Yourm5m5/InkDeck/CAD/images/inkdeck-drawing.png

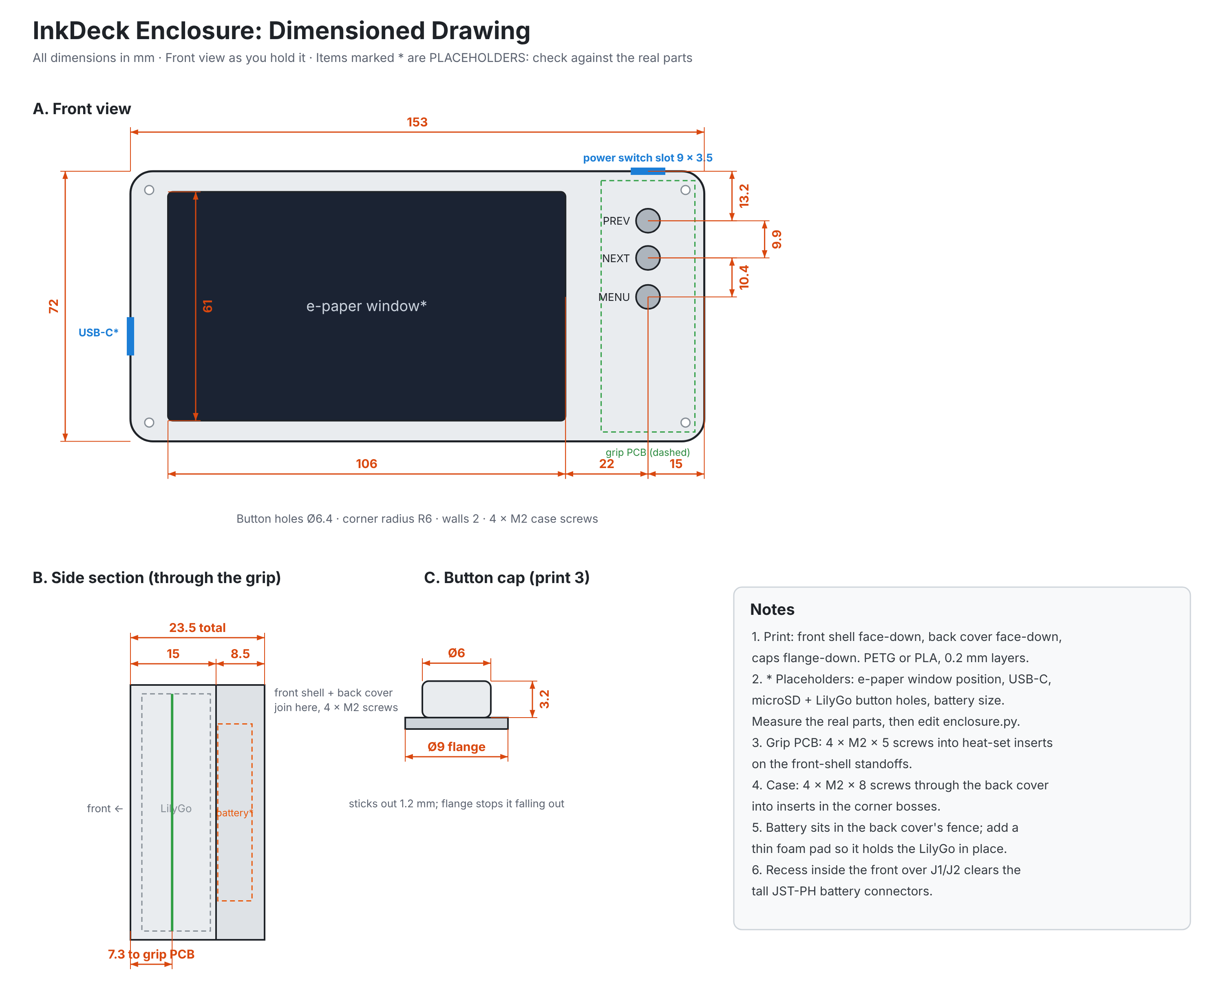
CAD/images/inkdeck-drawing.png
