Yourm5m5/InkDeck/CAD/images/inkdeck-exploded-rear.png

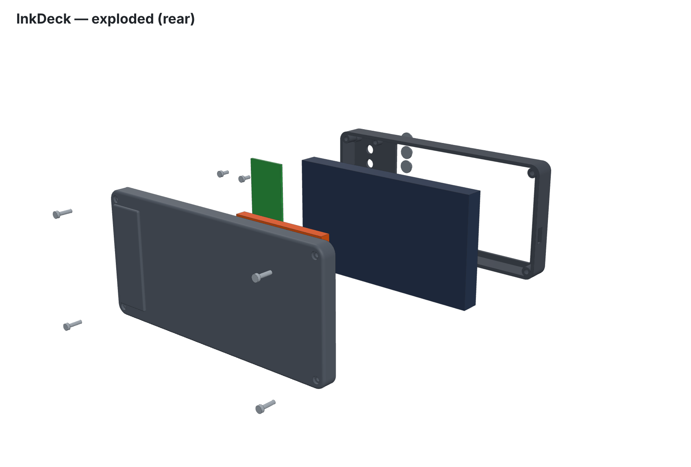
CAD/images/inkdeck-exploded-rear.png
