Yourm5m5/InkDeck/CAD/step/inkdeck_assembled_assembly.step

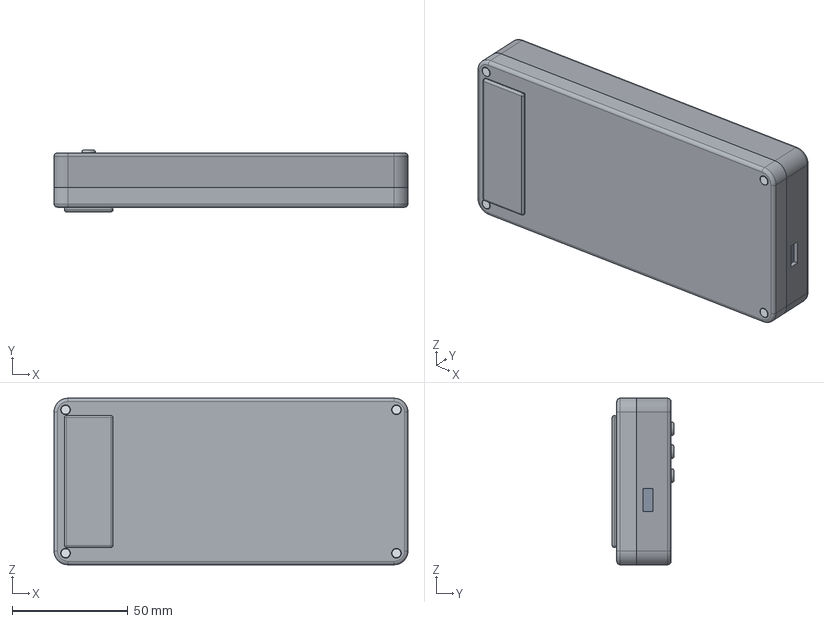
[picture p3: CAD file, 2026-10-25]
CAD/step/inkdeck_assembled_assembly.step
153.0 x 26.7 x 72.0 mm
caps
front
screen
lilygo
buttons
conns
grip
pscrew
battery
motor
back
cscrew
