Yourm5m5/InkDeck/CAD/step/inkdeck_exploded_assembly.step

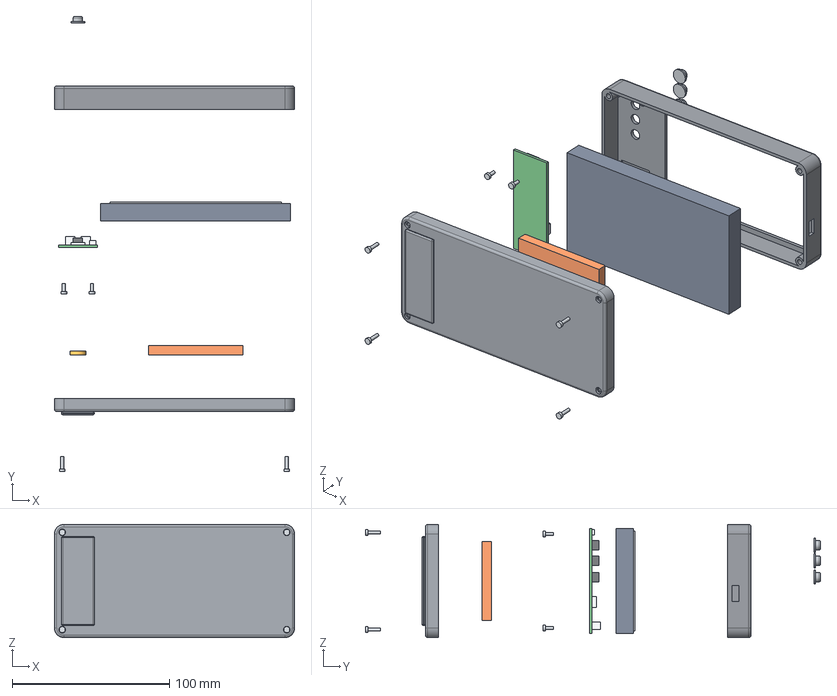
[picture p4: CAD file, 2026-10-25]
CAD/step/inkdeck_exploded_assembly.step
153.0 x 289.8 x 72.0 mm
caps
front
screen
lilygo
buttons
conns
grip
pscrew
battery
motor
back
cscrew
