Yourm5m5/InkDeck/CAD/step/inkdeck_assembly.step

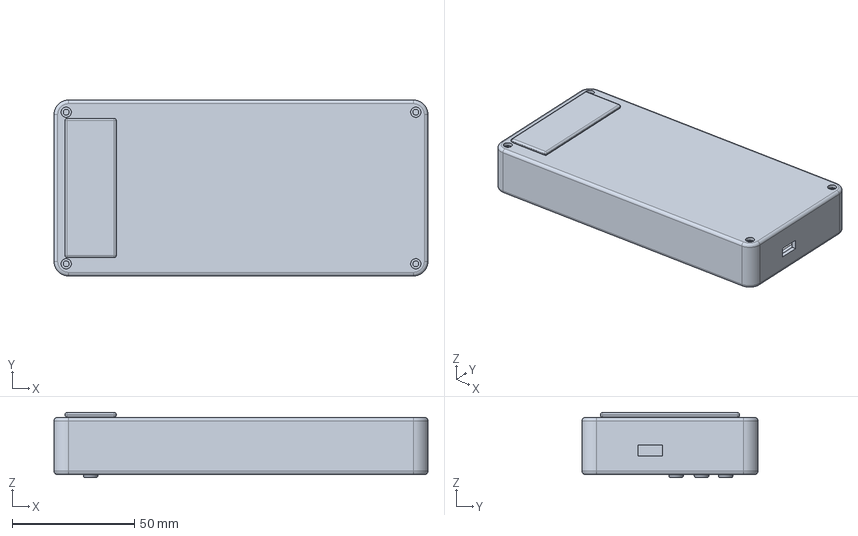
[picture p5: CAD file, 2026-10-17]
CAD/step/inkdeck_assembly.step
153.0 x 72.0 x 26.7 mm
