Yourm5m5/InkDeck/PCB/pcb.step

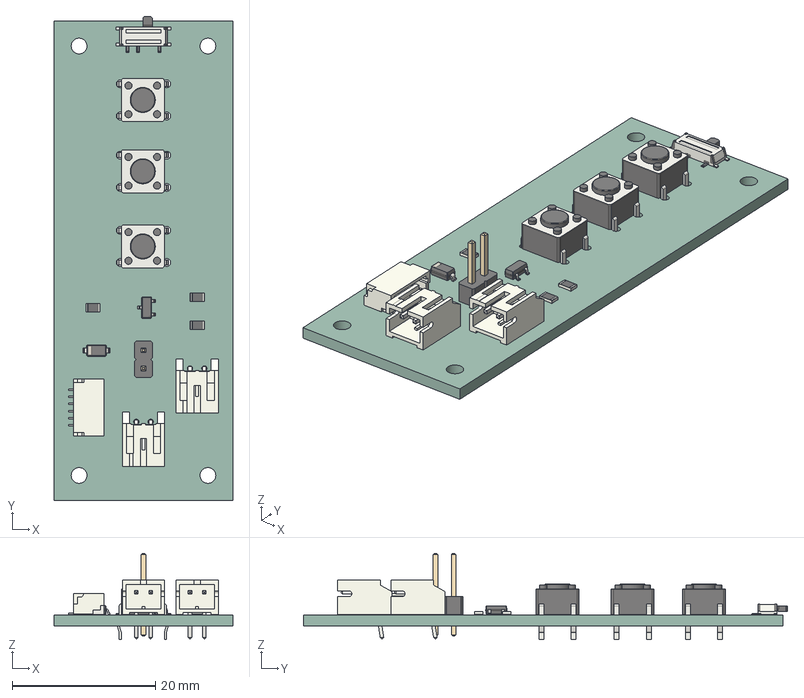
[picture p6: CAD file, 2026-10-25]
PCB/pcb.step
25.0 x 67.6 x 12.0 mm
JST_S2B_PH_K x 2
D_SOD-123
R_0805_2012Metric x 3
SW_PUSH_6mm x 3
Fusion_sp
PinHeader_1x02_P254mm_Vertical
SOT-23
JST_SH_SM06B-SRSS-TB_1x06-1MP_P1.00mm_Horizontal
Inkdeck_PCB
