Yourm5m5/InkDeck/CAD/step/inkdeck_back_cover.step

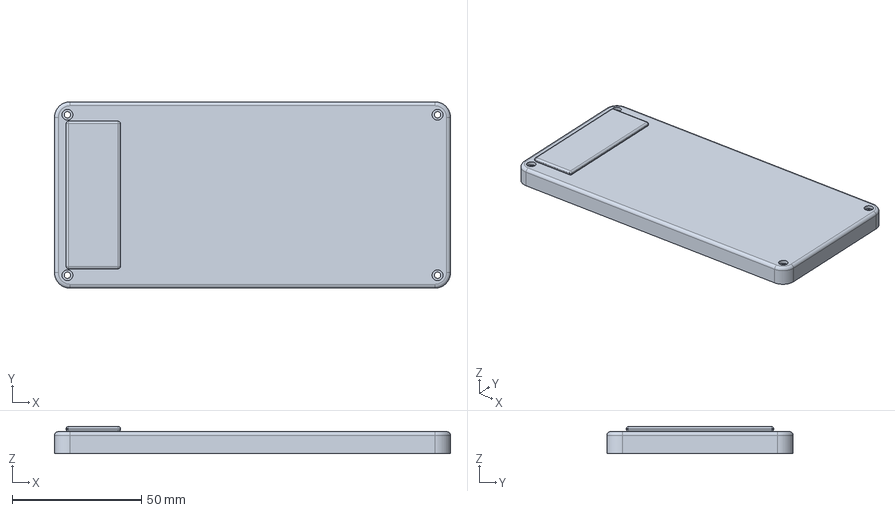
[picture p7: CAD file, 2026-10-17]
CAD/step/inkdeck_back_cover.step
153.0 x 72.0 x 10.5 mm
