Yourm5m5/InkDeck/CAD/step/inkdeck_button_cap.step

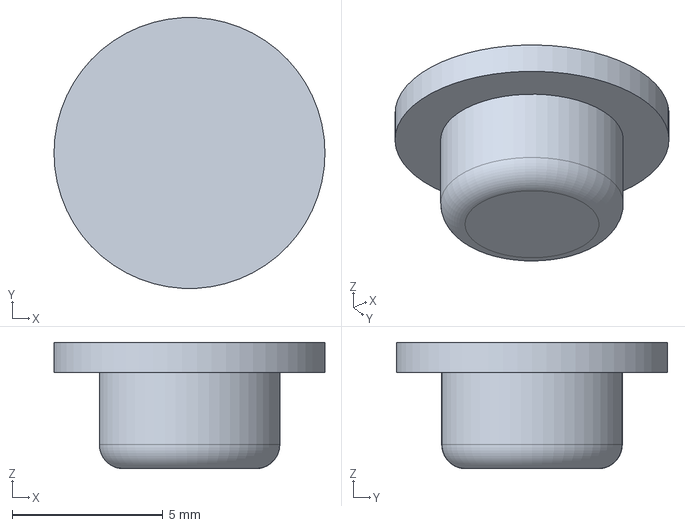
[picture p8: CAD file, 2026-10-17]
CAD/step/inkdeck_button_cap.step
9.00 x 8.99 x 4.20 mm
