Yourm5m5/InkDeck/CAD/step/inkdeck_front_shell.step

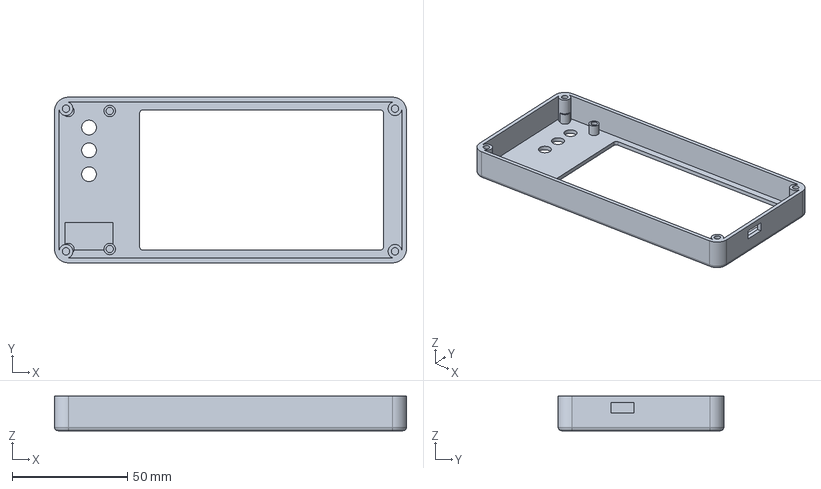
[picture p9: CAD file, 2026-10-17]
CAD/step/inkdeck_front_shell.step
153.0 x 72.0 x 15.0 mm
