Yourm5m5/InkDeck/(list of files, cad)

Other CAD files:
CAD/f3zfd3/inkdeck_assembled_assembly.f3z
CAD/f3zfd3/inkdeck_assembly.f3d
CAD/f3zfd3/inkdeck_back_cover.f3d
CAD/f3zfd3/inkdeck_button_cap.f3d
CAD/f3zfd3/inkdeck_front_shell.f3d
CAD/stl/inkdeck_assembly.stl
CAD/stl/inkdeck_back_cover.stl
CAD/stl/inkdeck_button_cap.stl
CAD/stl/inkdeck_front_shell.stl
