Yourm5m5/InkDeck/CAD/images/inkdeck-assembled.png

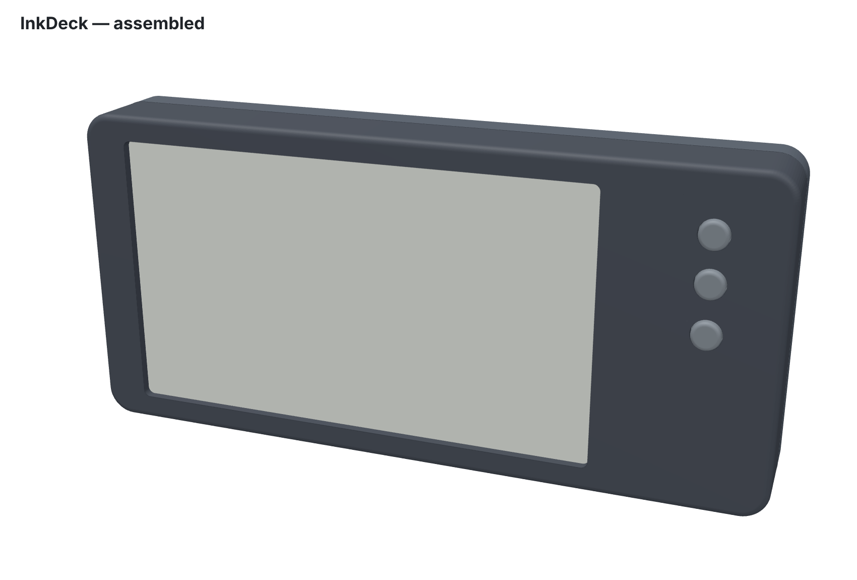
CAD/images/inkdeck-assembled.png
