Yourm5m5/InkDeck/PCB/_restore_backup_2026-10-16T16-21-23-037/Inkdeck.kicad_pcb

## KiCad design PCB/_restore_backup_2026-10-16T16-21-23-037/Inkdeck.kicad_pcb (2026-10-16)

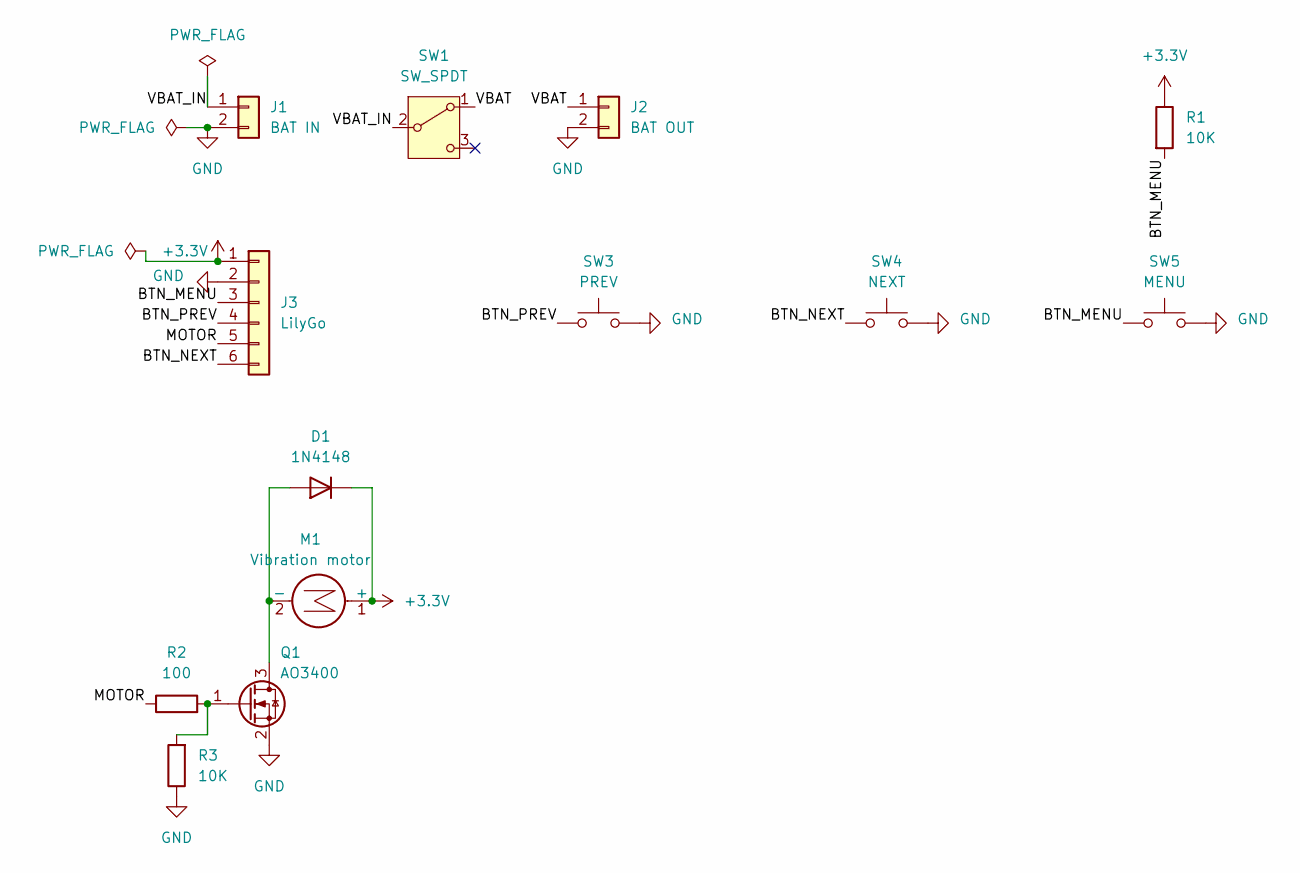
[picture p12: schematic Inkdeck.kicad_sch]

Parts:
D1: 1N4148; D_SOD-123
J1: BAT IN; JST_PH_S2B-PH-K_1x02_P2.00mm_Horizontal
J2: BAT OUT; JST_PH_S2B-PH-K_1x02_P2.00mm_Horizontal
J3: LilyGo; JST_SH_SM06B-SRSS-TB_1x06-1MP_P1.00mm_Horizontal
M1: Vibration motor; PinHeader_1x02_P2.54mm_Vertical
Q1: AO3400; SOT-23
R1, R3: 10K; R_0805_2012Metric
R2: 100; R_0805_2012Metric
SW1: SW_SPDT; SW_SPDT_PCM12
SW3: PREV; SW_PUSH_6mm
SW4: NEXT; SW_PUSH_6mm
SW5: MENU; SW_PUSH_6mm

Connections:
+3.3V: D1.1 (K), J3.1, M1.1 (+), R1.1
/BTN_MENU: J3.3, R1.2, SW5.1
/BTN_NEXT: J3.6, SW4.1
/BTN_PREV: J3.4, SW3.1
/MOTOR: J3.5, R2.1
/VBAT: J2.1, SW1.1 (A)
/VBAT_IN: J1.1, SW1.2 (B)
GND: J1.2, J2.2, J3.2, Q1.2 (S), R3.1, SW3.2, SW4.2, SW5.2
unnamed: D1.2 (A), M1.2 (-), Q1.3 (D)
unnamed: Q1.1 (G), R2.2, R3.2

Board: 2 copper layers, 13 parts (0 on the bottom side), 10 nets, no tracks yet.
